nettenxa/NSC/Image/265428386_1372703366477929_293231923148097490_n.jpg

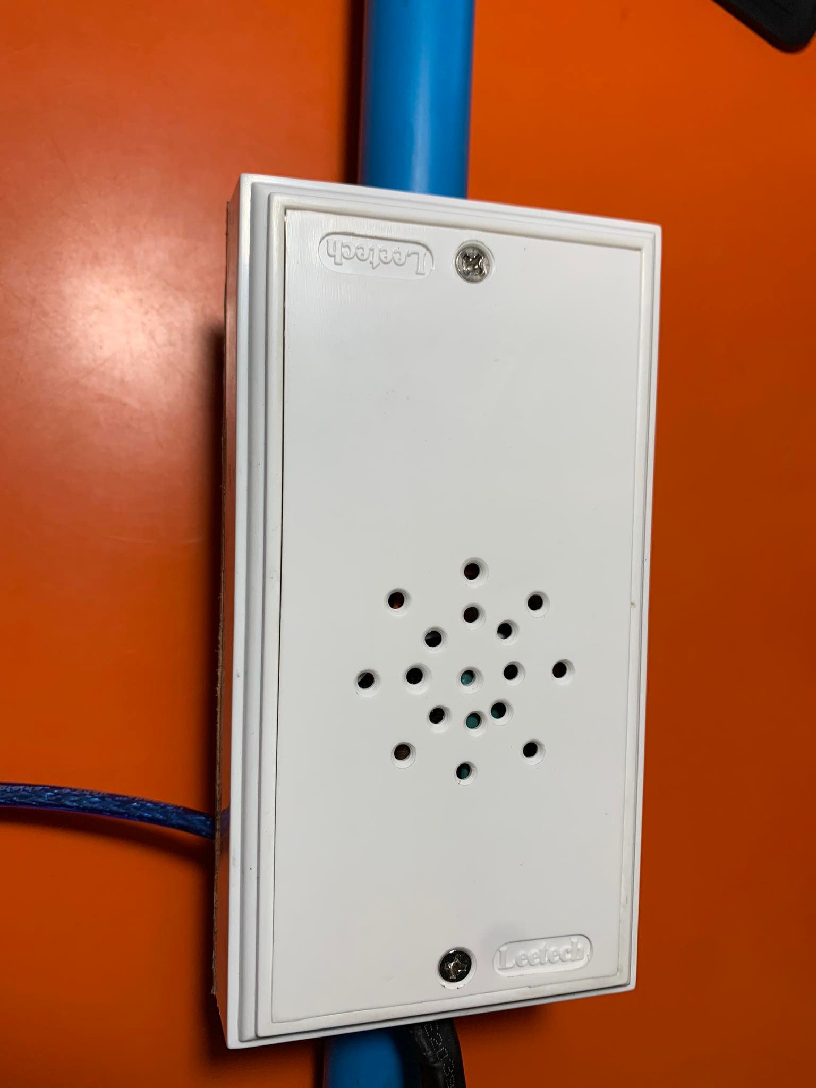
Image/265428386_1372703366477929_293231923148097490_n.jpg
