nettenxa/NSC/Image/กล่อง/sensortail.jpg

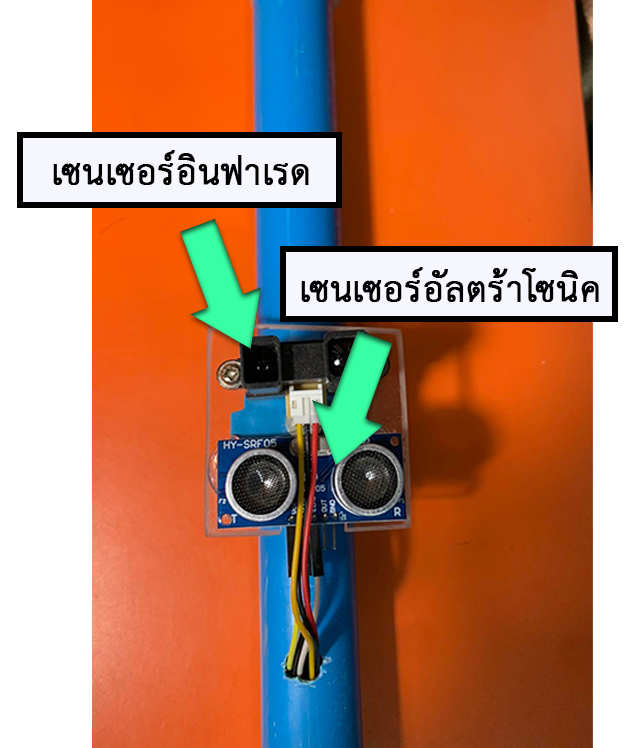
Image/กล่อง/sensortail.jpg
