nettenxa/NSC/Design/2.jpg

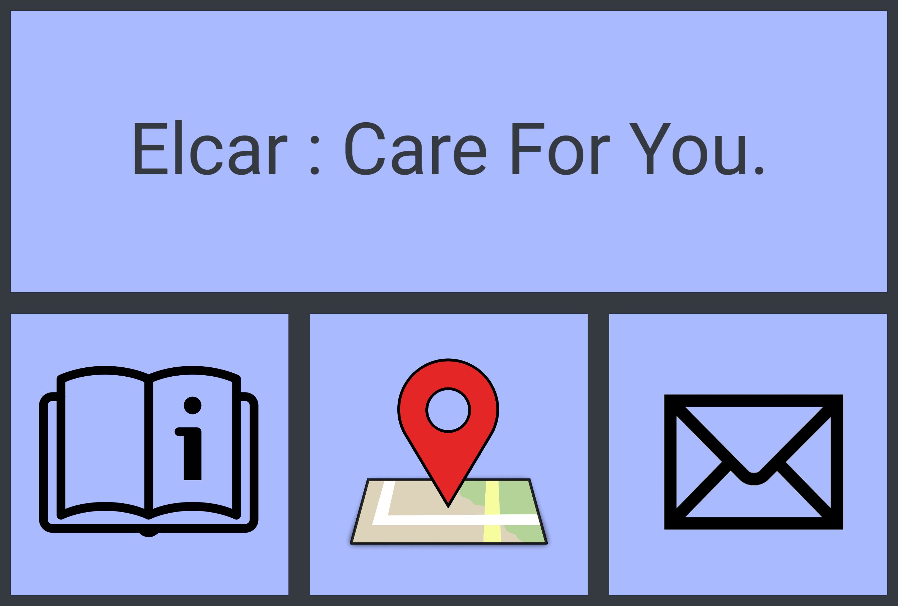
Design/2.jpg
