nettenxa/NSC/Design/Connection.png

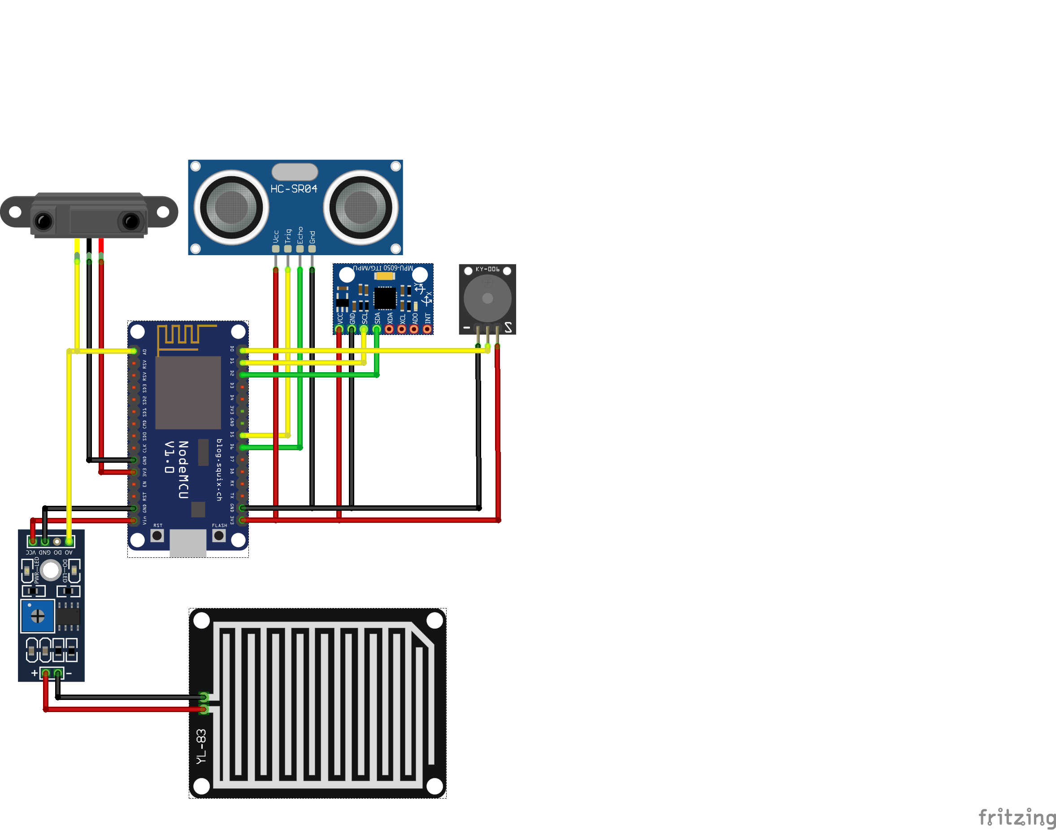
Design/Connection.png
