nettenxa/NSC/Design/Connection_bb-2-Out.png

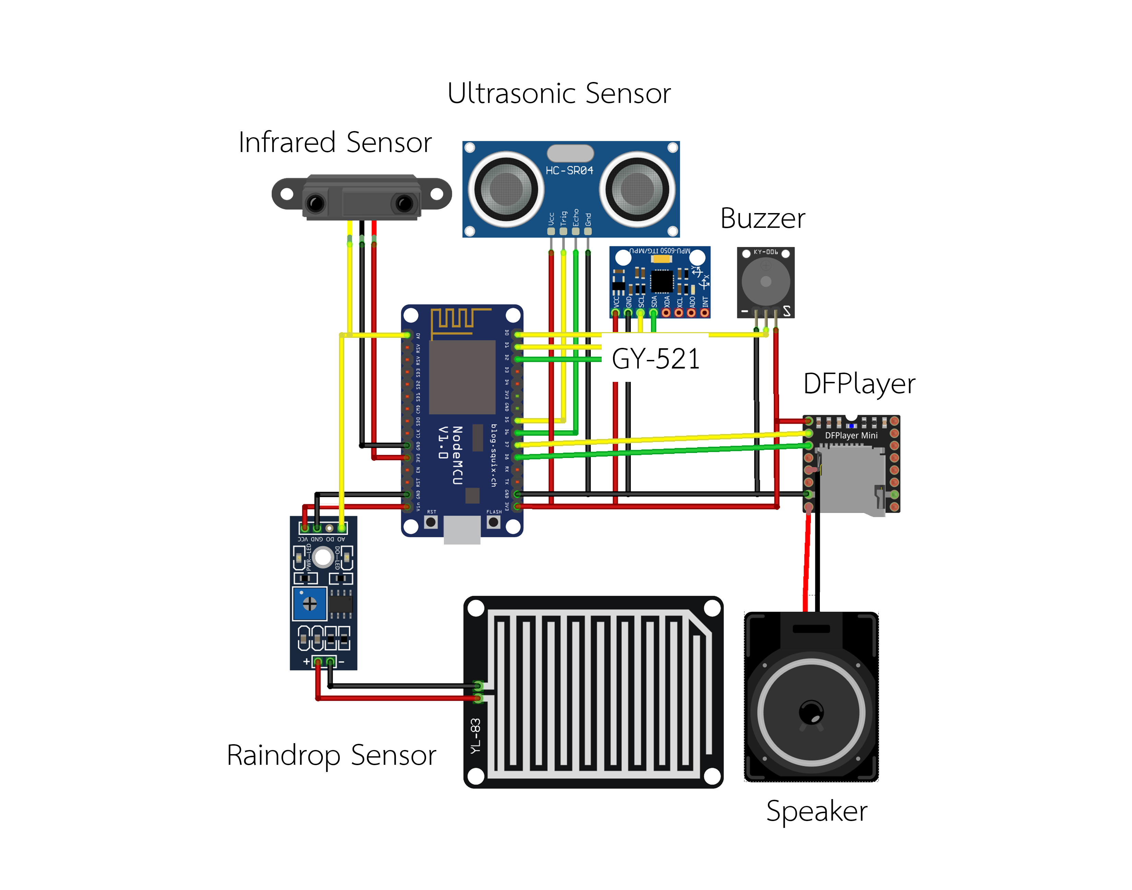
Design/Connection_bb-2-Out.png
