nettenxa/NSC/Design/Connection_bb-2.png

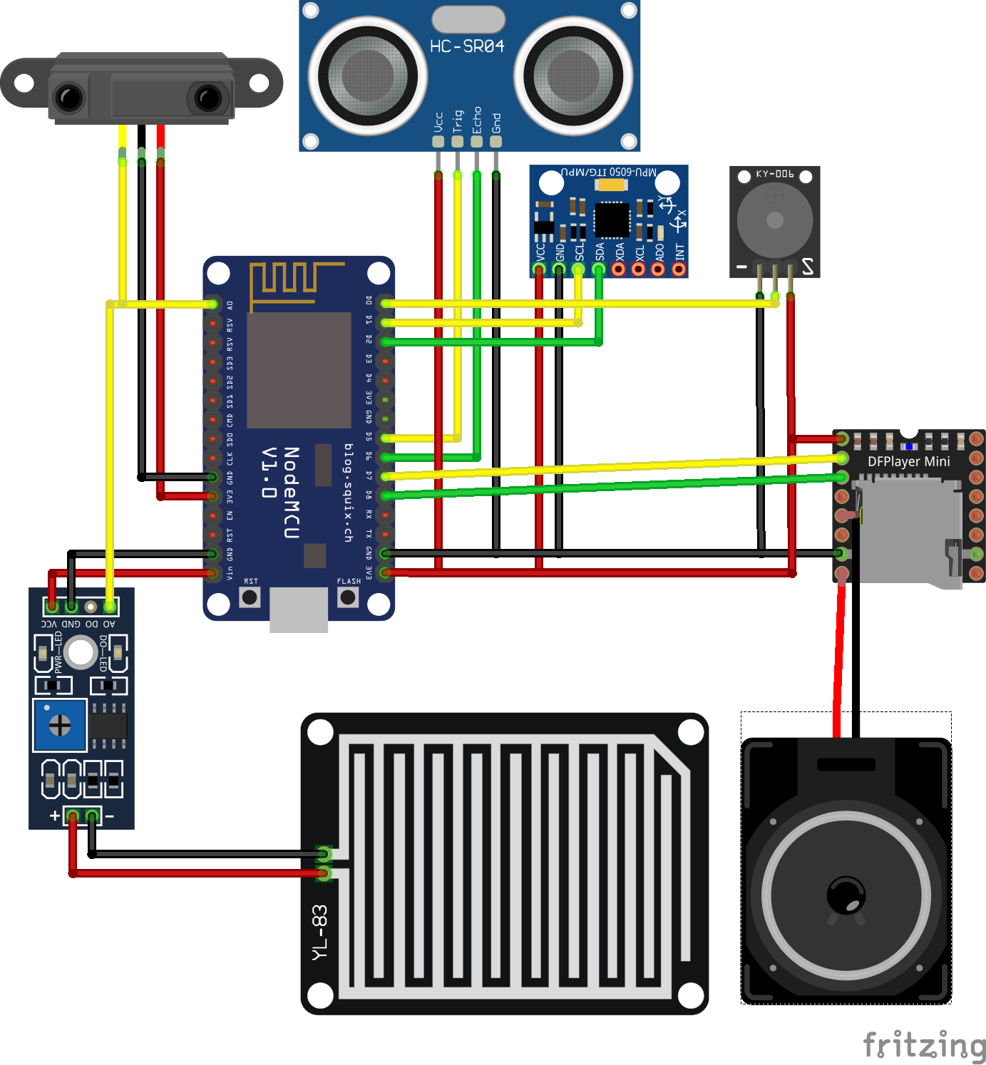
Design/Connection_bb-2.png
