nettenxa/NSC/gg.png

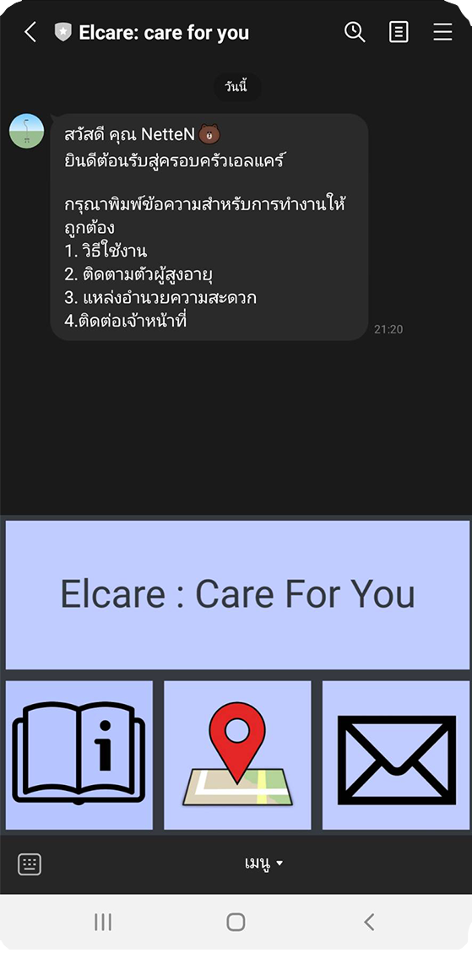
gg.png
