nettenxa/NSC/Image/264776138_958256581741034_5406571611317067341_n.jpg

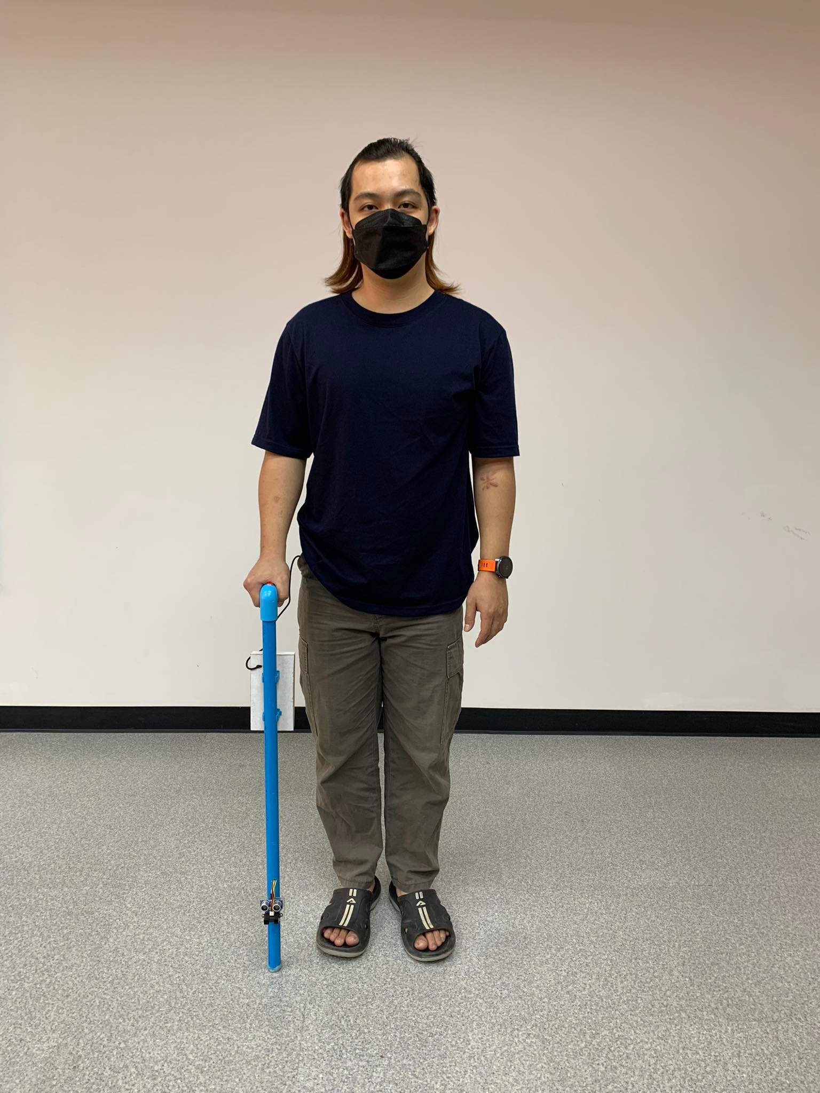
Image/264776138_958256581741034_5406571611317067341_n.jpg
