nettenxa/NSC/Image/264822803_423899012765740_6742990639540808056_n.jpg

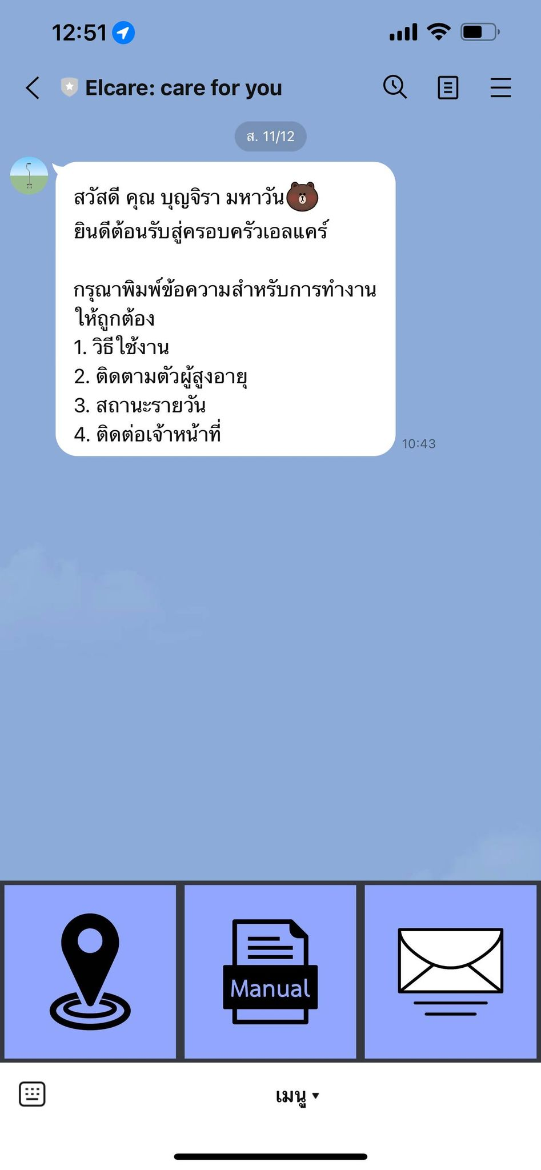
Image/264822803_423899012765740_6742990639540808056_n.jpg
