nettenxa/NSC/Image/265014105_638923154228100_4338517416619523832_n.jpg

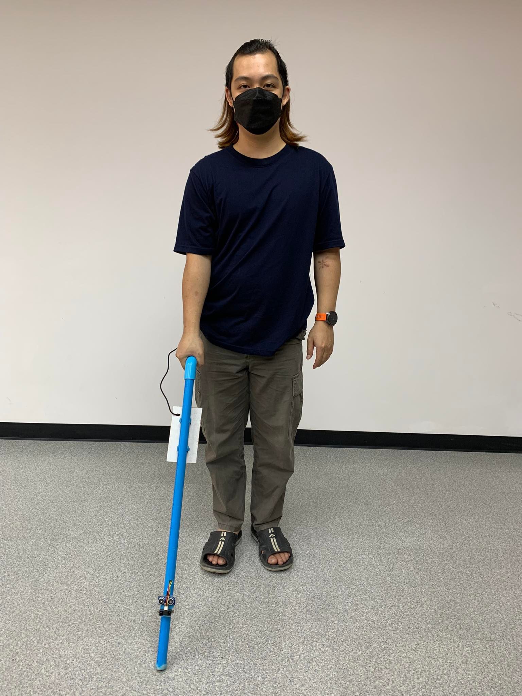
Image/265014105_638923154228100_4338517416619523832_n.jpg
