nettenxa/NSC/Image/265110683_572321093874357_3556969206067001572_n.jpg

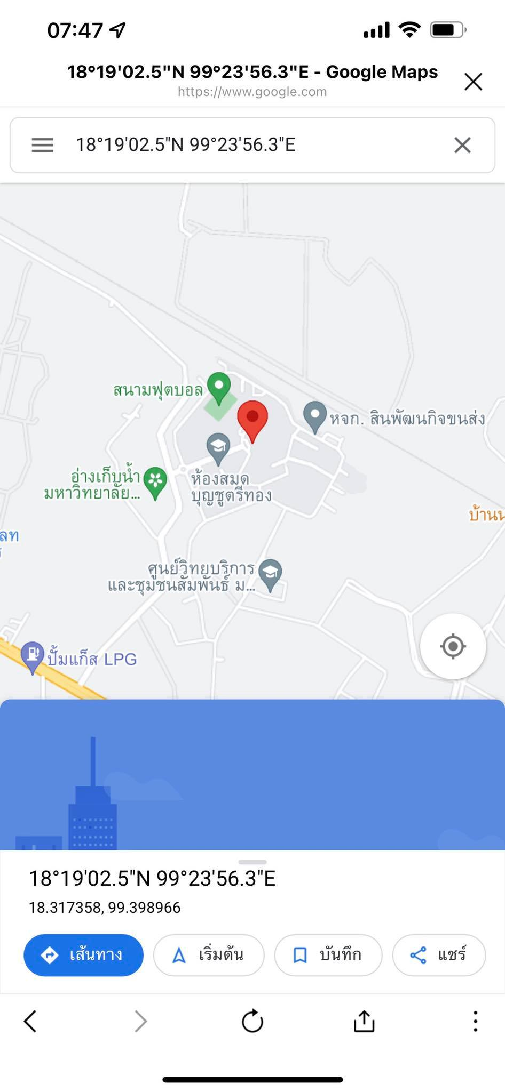
Image/265110683_572321093874357_3556969206067001572_n.jpg
