nettenxa/NSC/Image/265531771_935682650676566_1253015456427634819_n.jpg

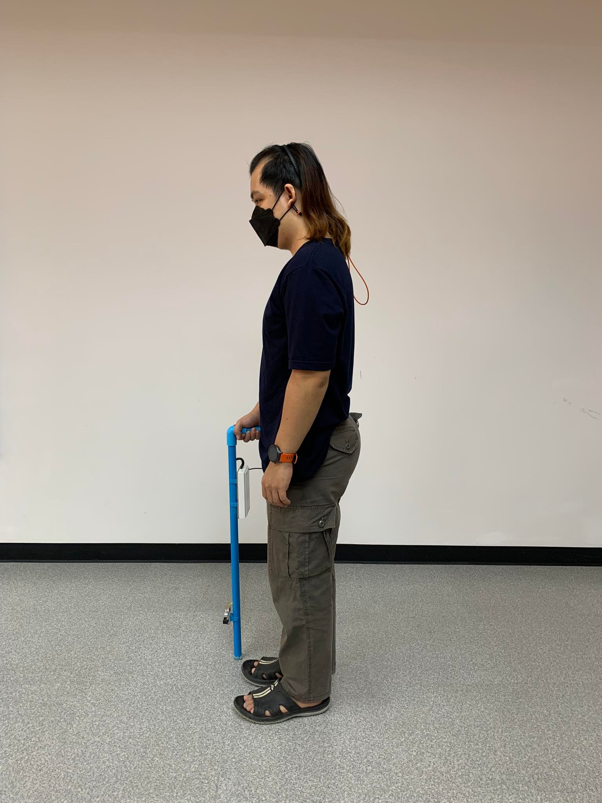
Image/265531771_935682650676566_1253015456427634819_n.jpg
