nettenxa/NSC/Image/266010837_924534368181699_8959451366715135956_n.jpg

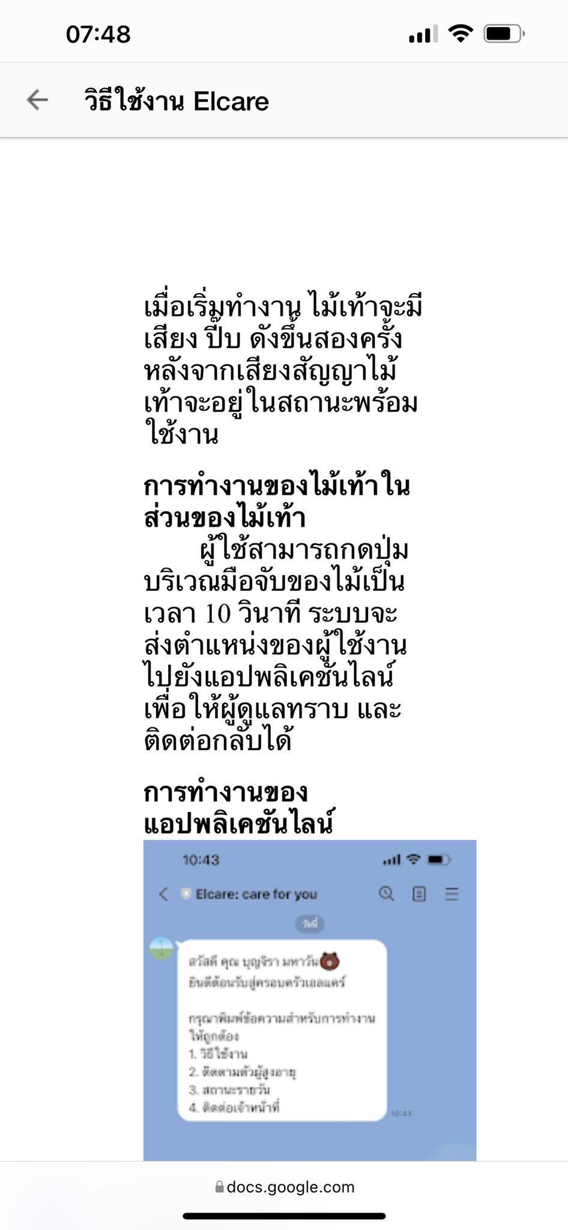
Image/266010837_924534368181699_8959451366715135956_n.jpg
