nettenxa/NSC/Image/266121671_282369093844458_5179473564367191443_n.jpg

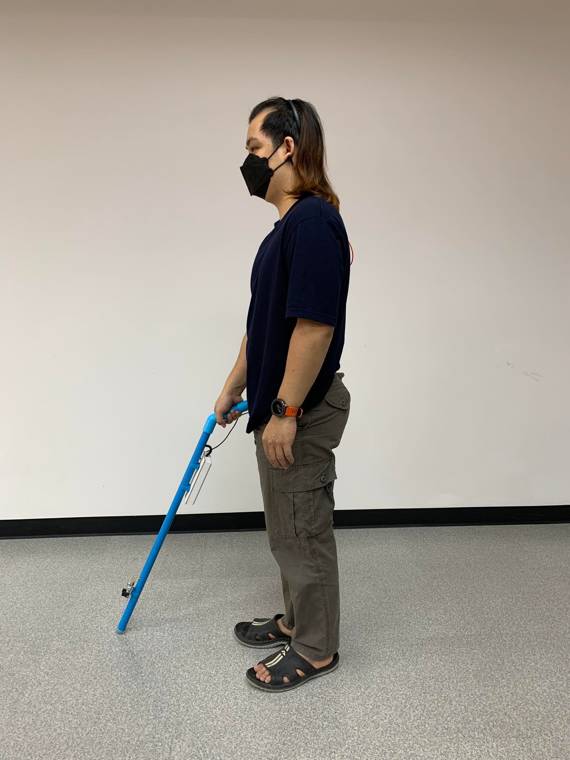
Image/266121671_282369093844458_5179473564367191443_n.jpg
