nettenxa/NSC/Image/266489193_1093051948185362_3606315569262096377_n.jpg

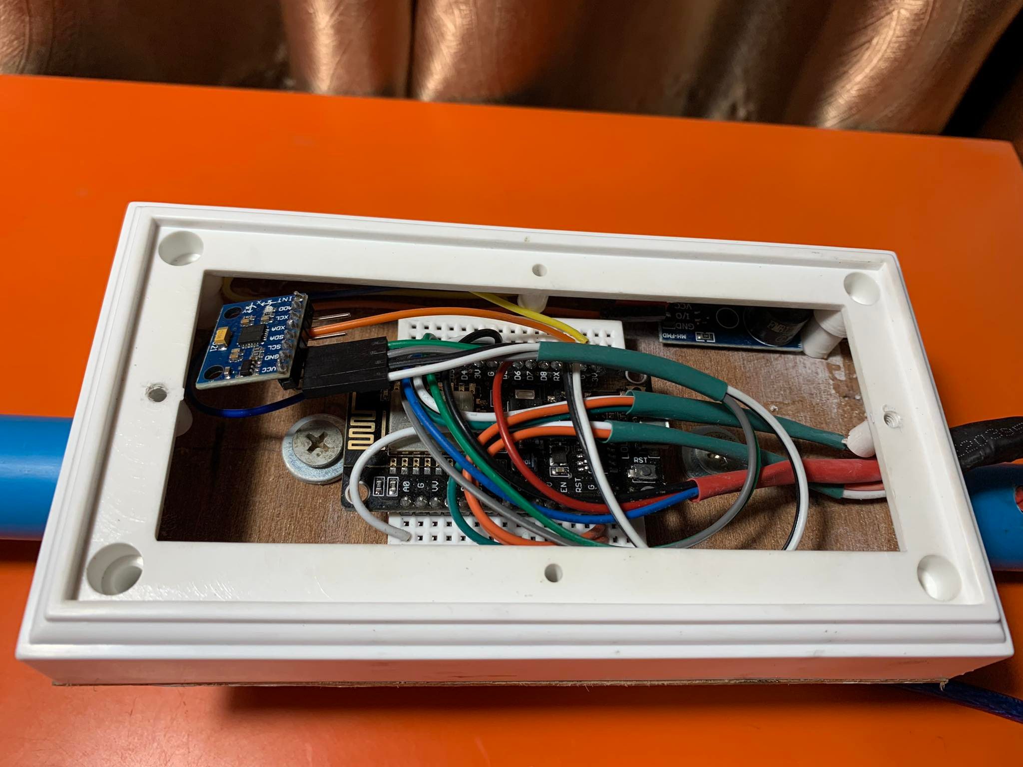
Image/266489193_1093051948185362_3606315569262096377_n.jpg
