nettenxa/NSC/Image/266701049_331945328578467_1472730055581550721_n.jpg

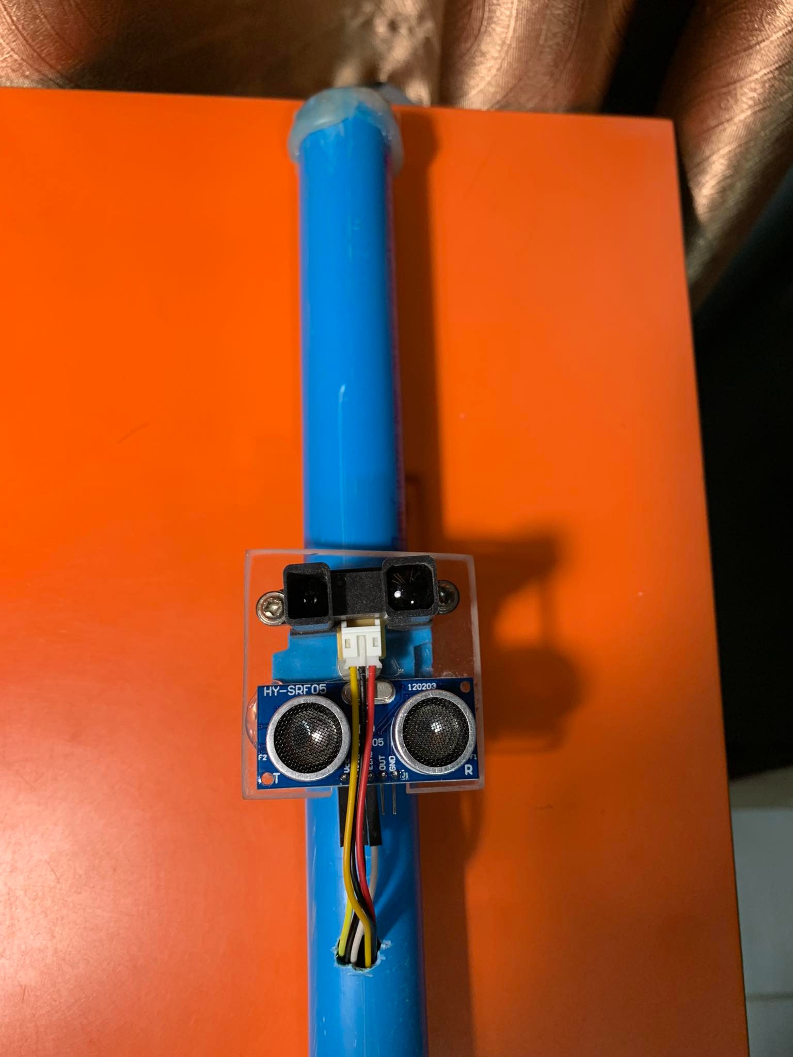
Image/266701049_331945328578467_1472730055581550721_n.jpg
