nettenxa/NSC/Image/266968699_627225355388466_1541936651428918515_n.jpg

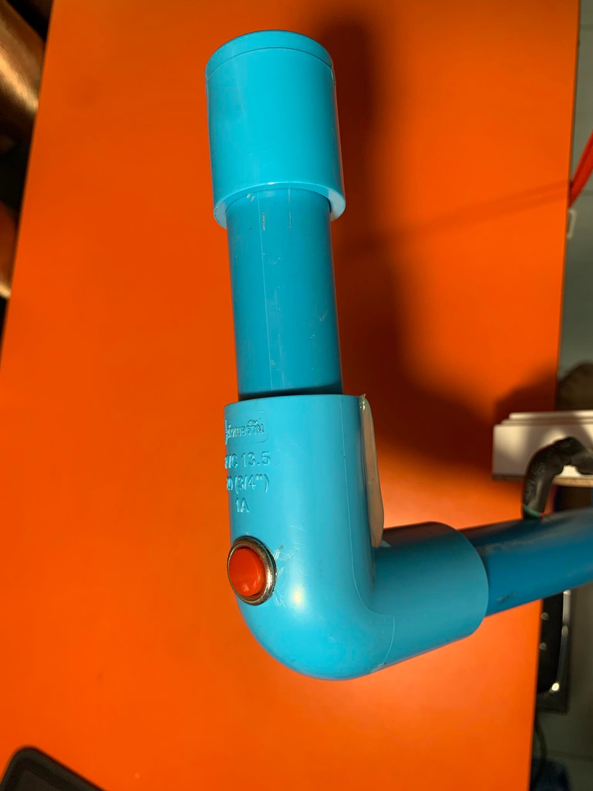
Image/266968699_627225355388466_1541936651428918515_n.jpg
