nettenxa/NSC/Image/267014538_4587867214637260_2955878110535487857_n.jpg

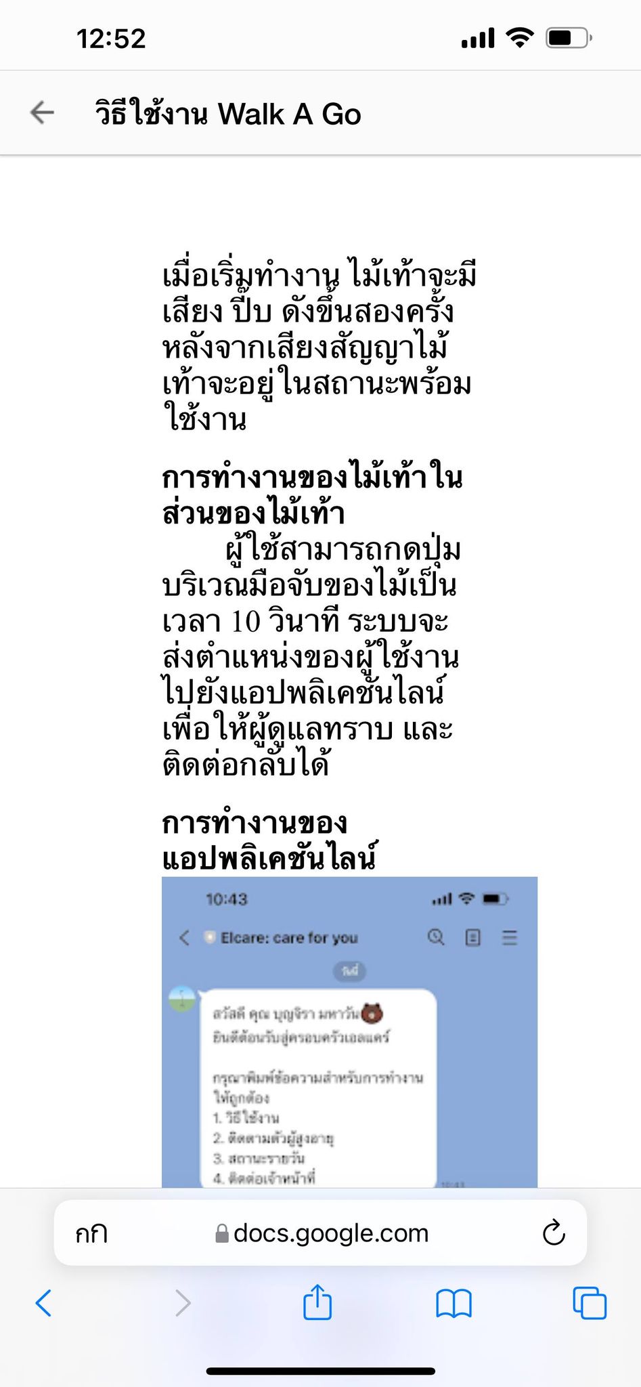
Image/267014538_4587867214637260_2955878110535487857_n.jpg
