nettenxa/NSC/Image/267402559_982161962650128_3099172975754466114_n.jpg

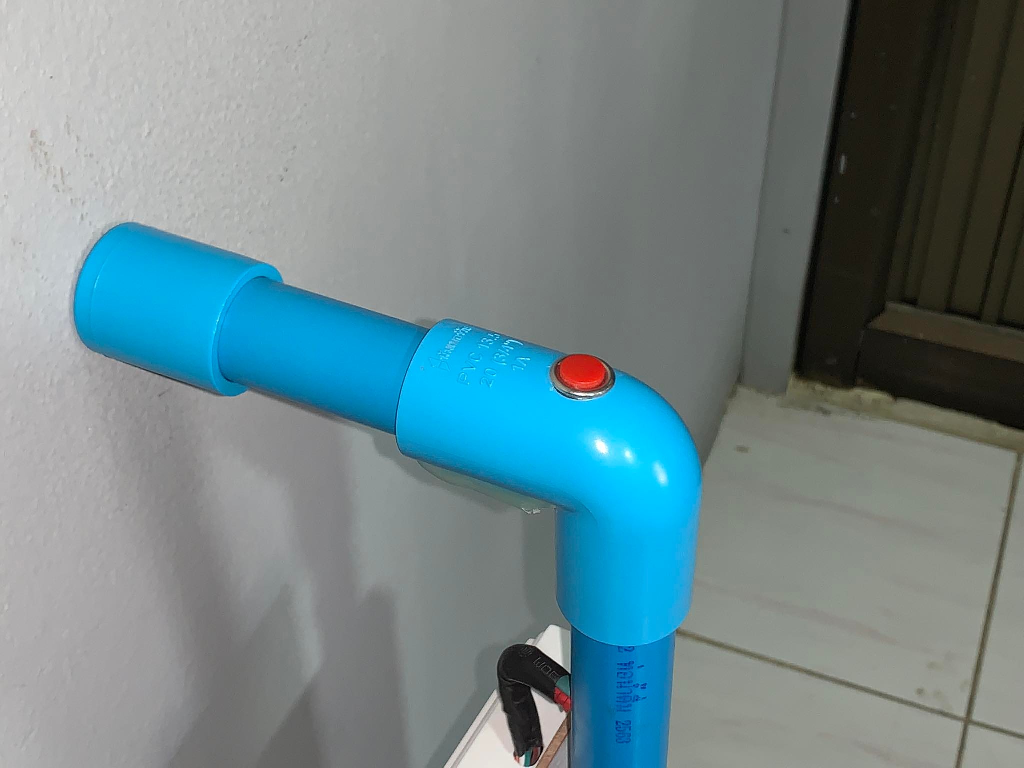
Image/267402559_982161962650128_3099172975754466114_n.jpg
