nettenxa/NSC/Image/267537610_1544595275903317_5843541208619142849_n.jpg

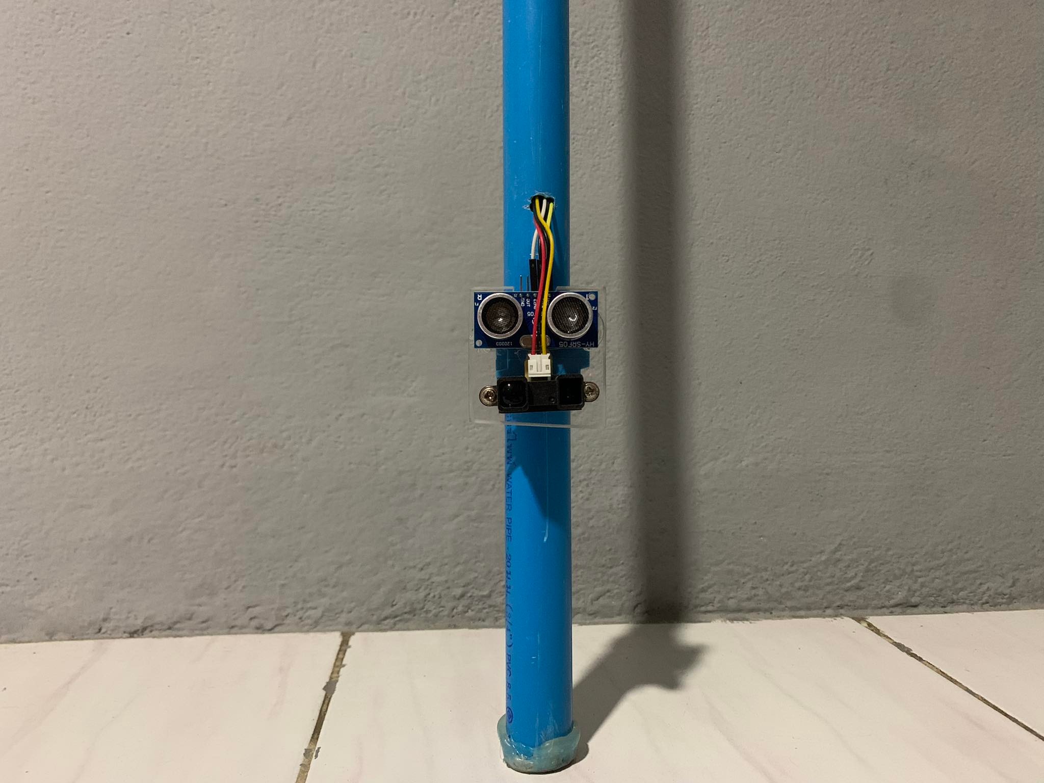
Image/267537610_1544595275903317_5843541208619142849_n.jpg
