nettenxa/NSC/Image/AUCC2022.drawio.png

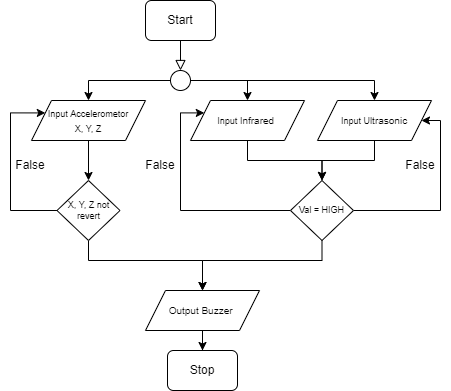
Image/AUCC2022.drawio.png
