nettenxa/NSC/Image/Hand.png

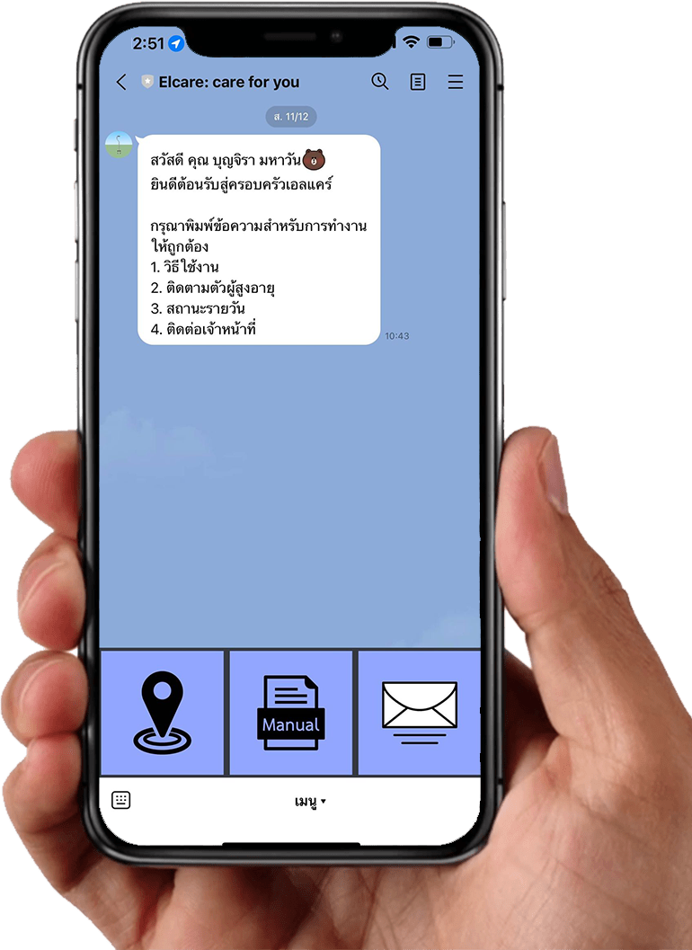
Image/Hand.png
