nettenxa/NSC/Image/Out copy.png

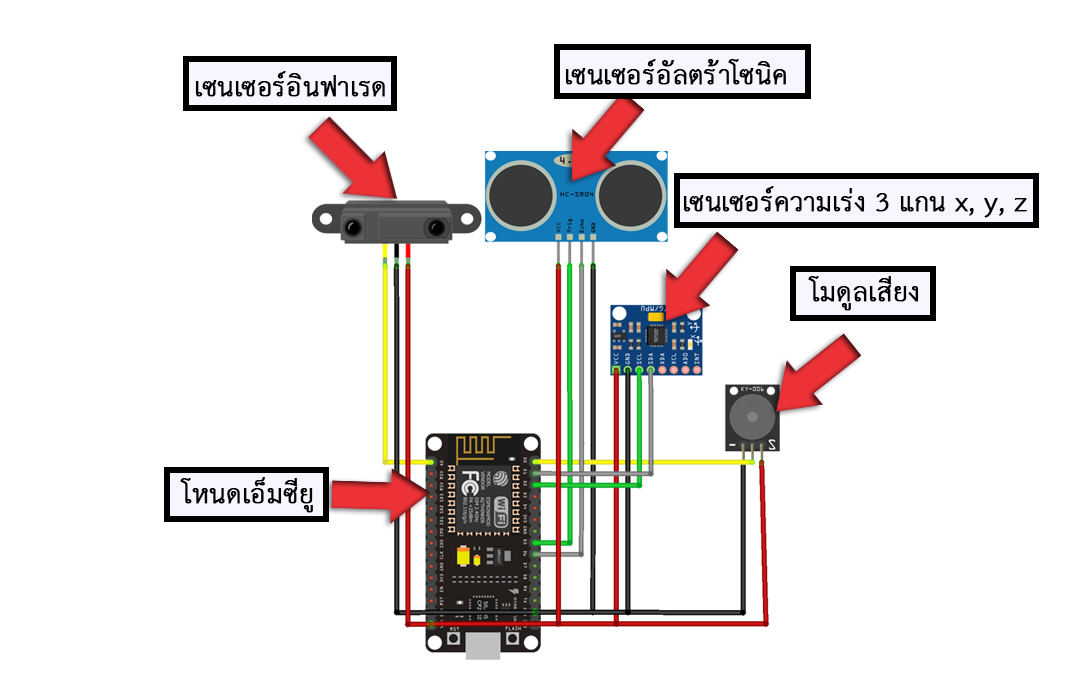
Image/Out copy.png
