nettenxa/NSC/Image/OutPro.png

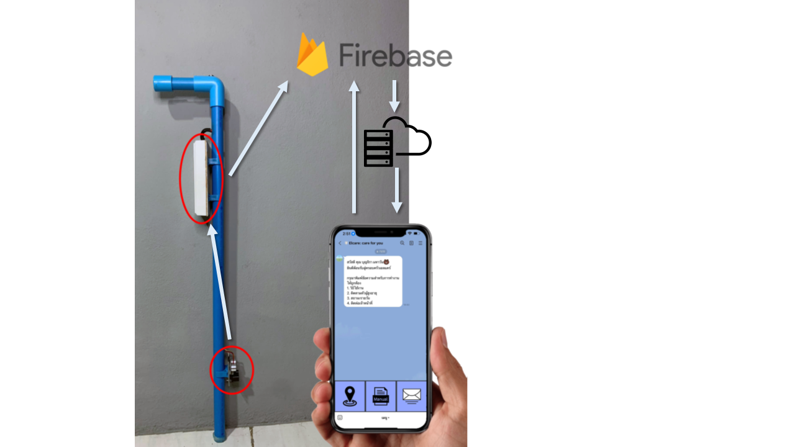
Image/OutPro.png
