nettenxa/NSC/Image/กล่อง/sensor.jpg

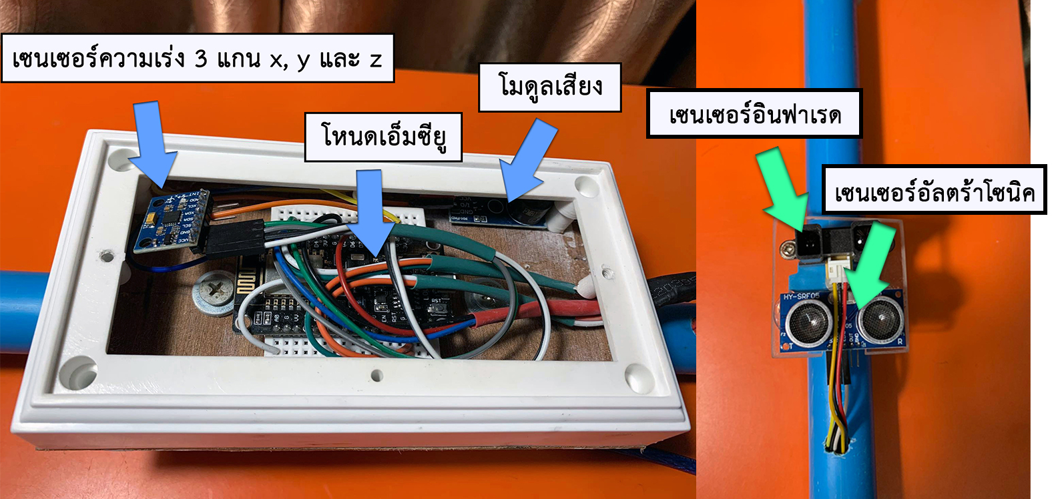
Image/กล่อง/sensor.jpg
