nettenxa/NSC/Image/กล่อง/ปิดฝา.jpg

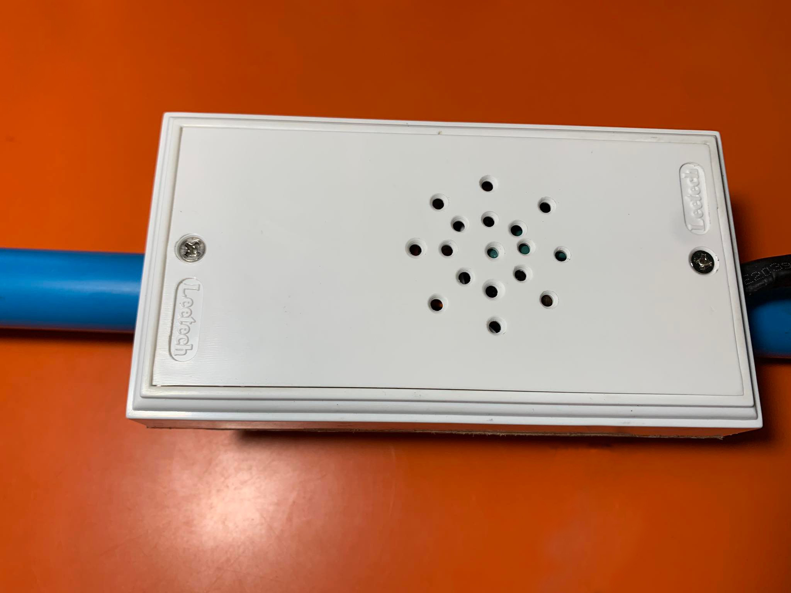
Image/กล่อง/ปิดฝา.jpg
