nettenxa/NSC/Image/กล่อง/เปิดฝาBB.jpg

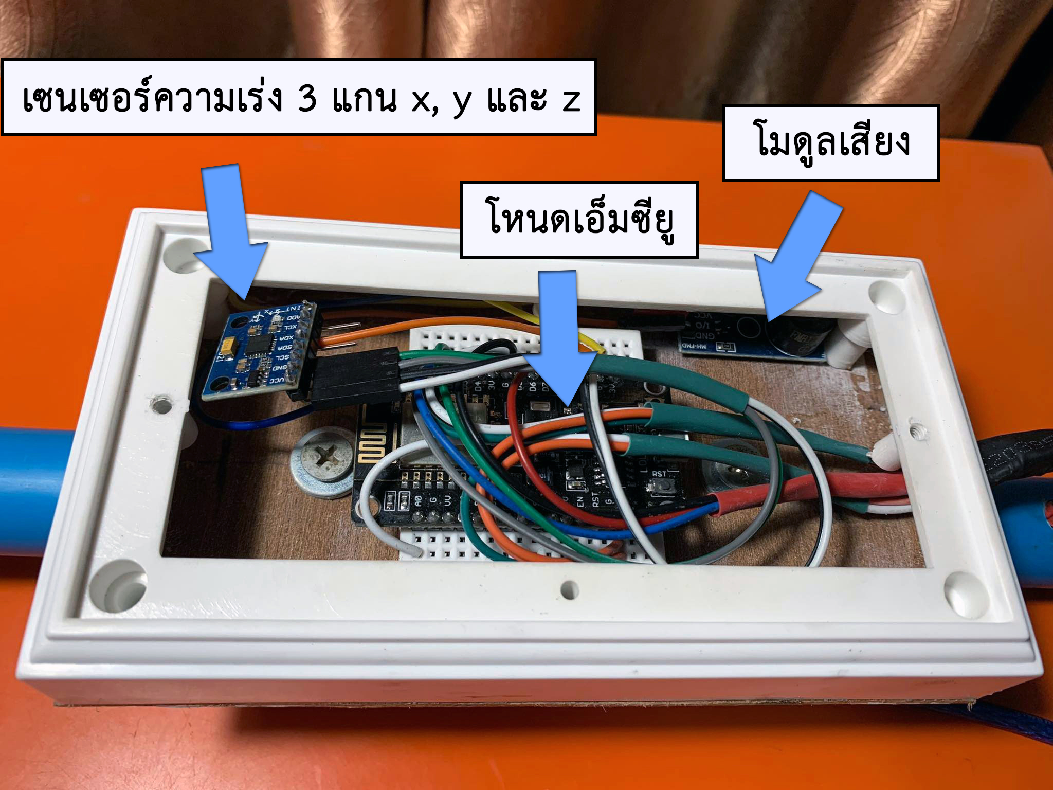
Image/กล่อง/เปิดฝาBB.jpg
