nettenxa/NSC/Image/ภาพรวม.jpg

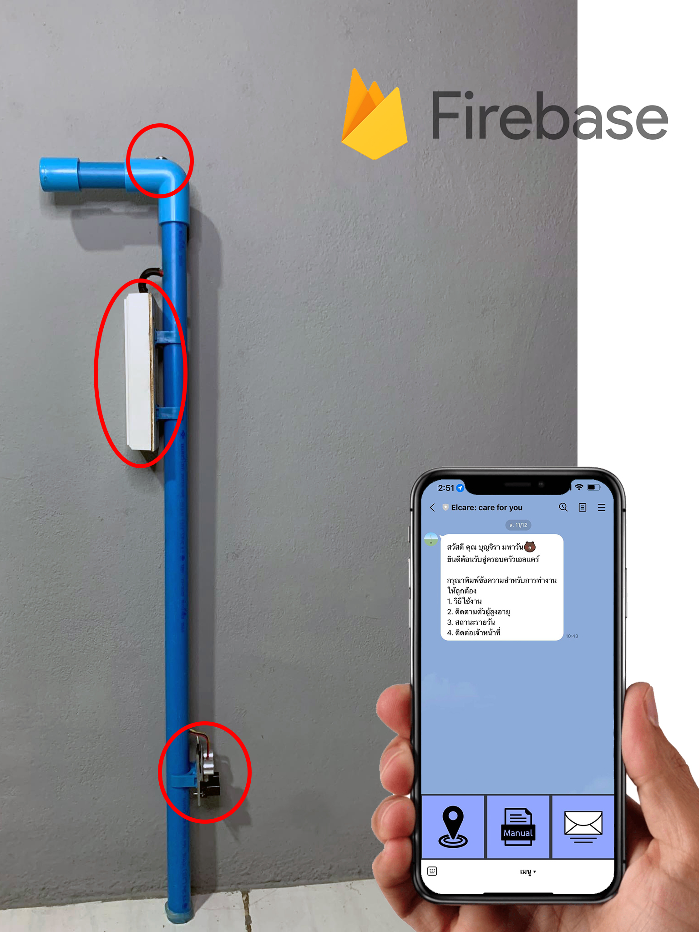
Image/ภาพรวม.jpg
