nettenxa/NSC/Image/รูปภาพ1.jpg

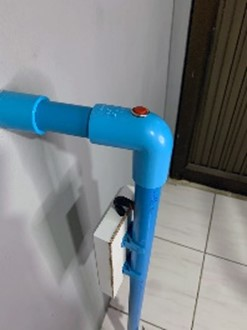
Image/รูปภาพ1.jpg
