nettenxa/NSC/Line Image/415.jpg

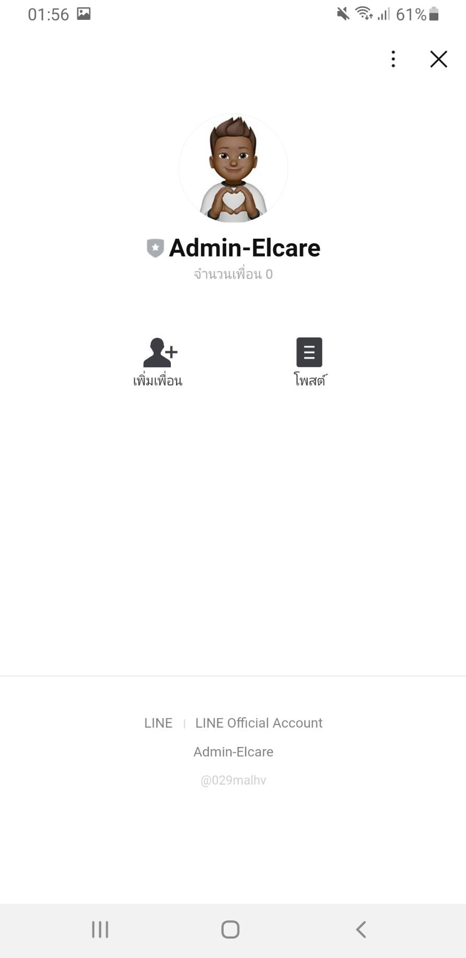
Line Image/415.jpg
