nettenxa/NSC/Line Image/416.jpg

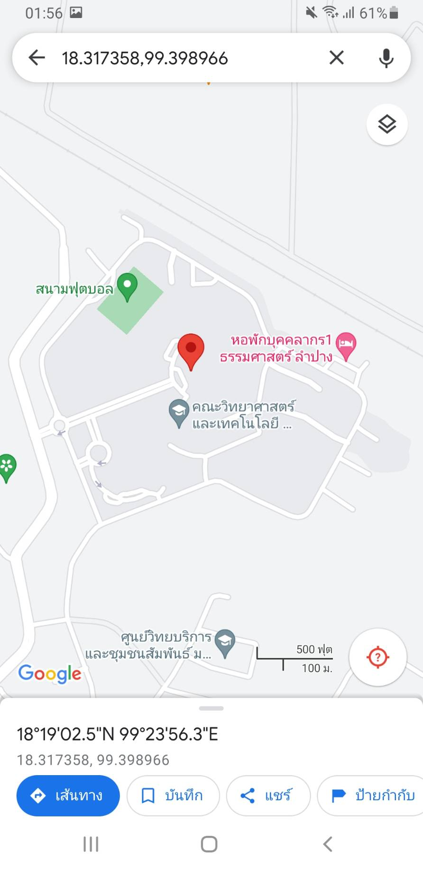
Line Image/416.jpg
