nettenxa/NSC/Line Image/Home 2.jpg

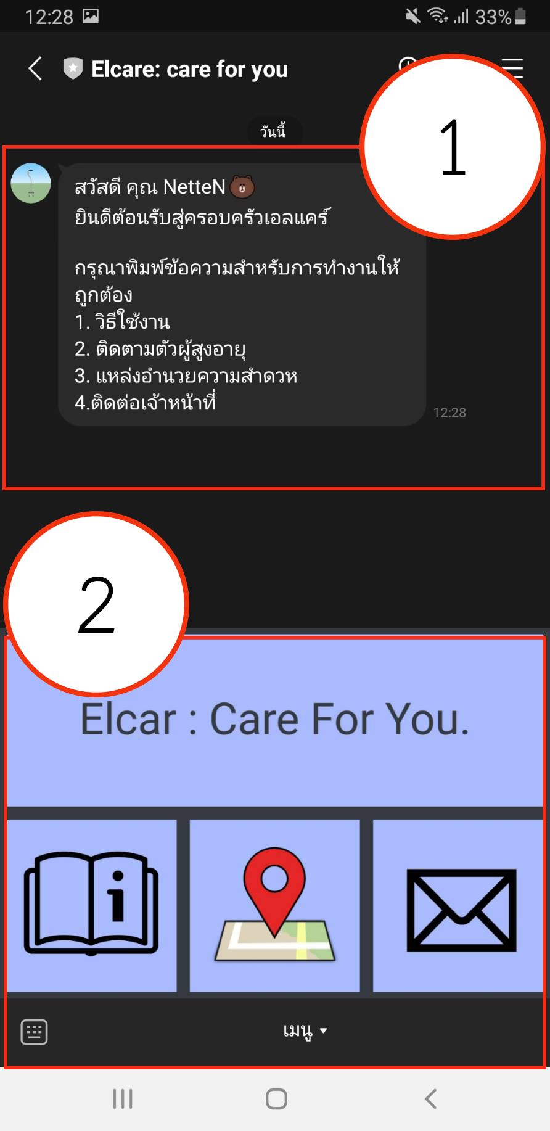
Line Image/Home 2.jpg
