nettenxa/NSC/Line Image/ผู้ใช้งาน/445.jpg

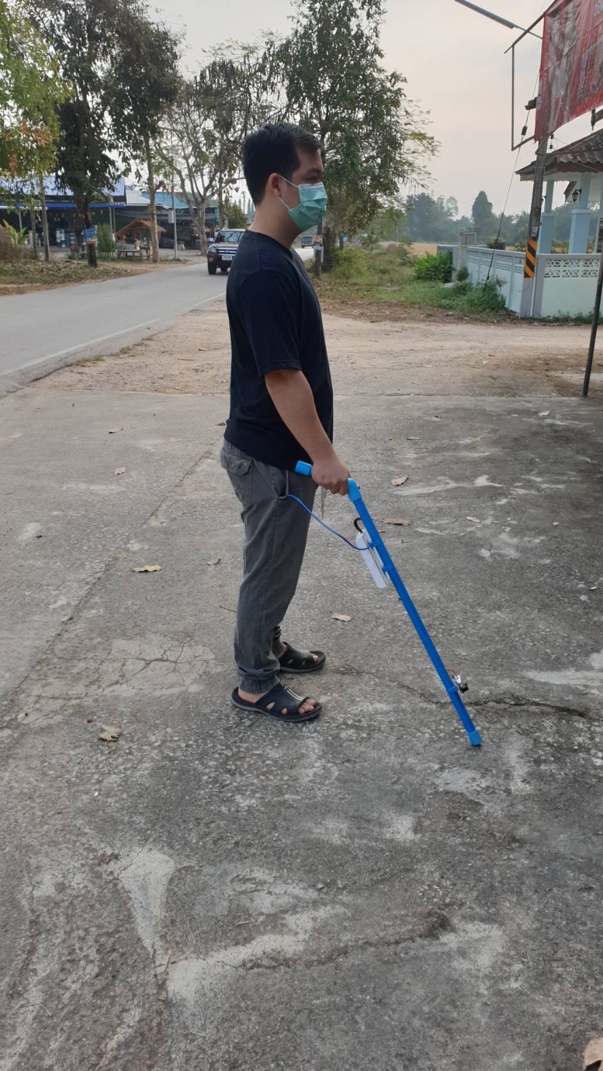
Line Image/ผู้ใช้งาน/445.jpg
