nettenxa/NSC/Line Image/ผู้ใช้งาน/446.jpg

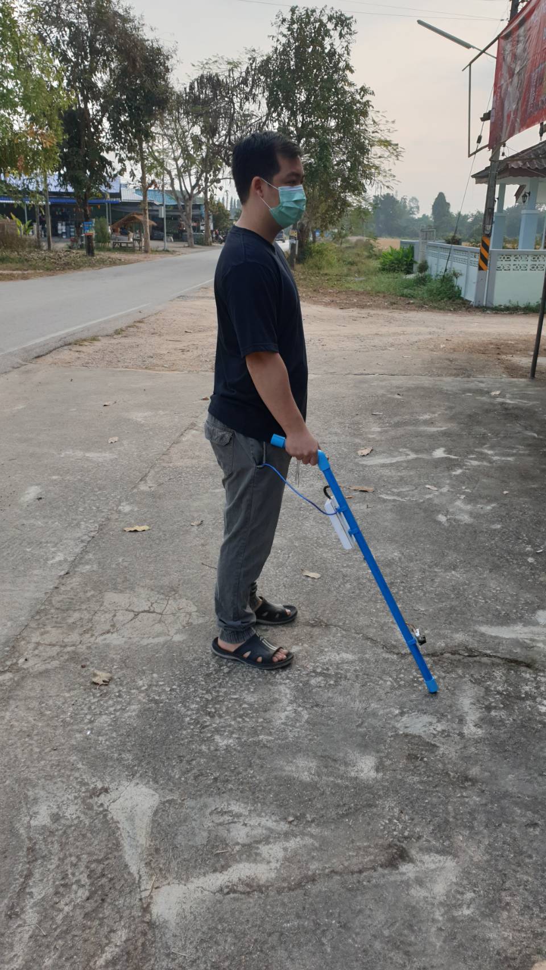
Line Image/ผู้ใช้งาน/446.jpg
