nettenxa/NSC/Line Image/ผู้ใช้งาน/448.jpg

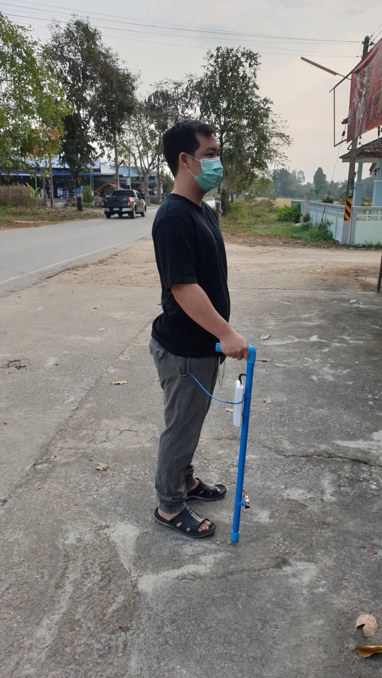
Line Image/ผู้ใช้งาน/448.jpg
