nettenxa/NSC/Line Image/ผู้ใช้งาน/449.jpg

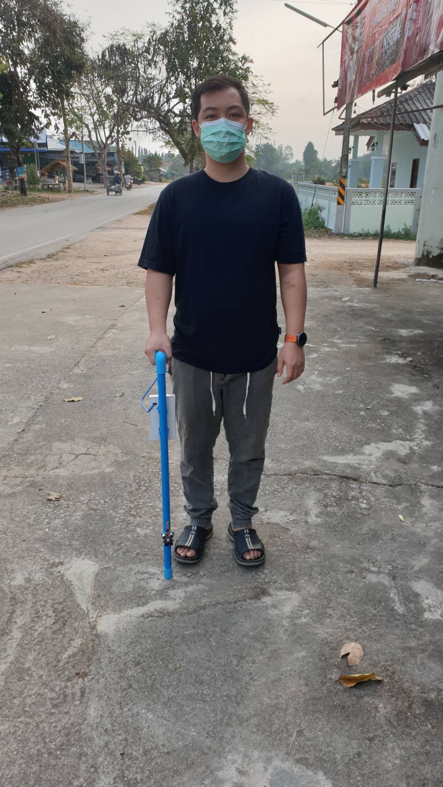
Line Image/ผู้ใช้งาน/449.jpg
