nettenxa/NSC/Line Image/อุปกรณ์/1.jpg

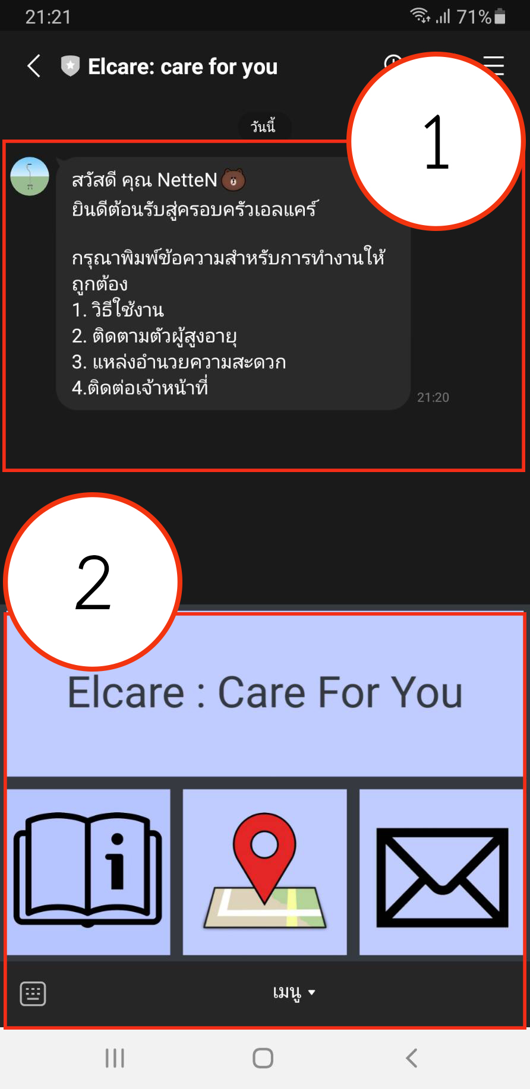
Line Image/อุปกรณ์/1.jpg
