nettenxa/NSC/Line Image/อุปกรณ์/2.jpg

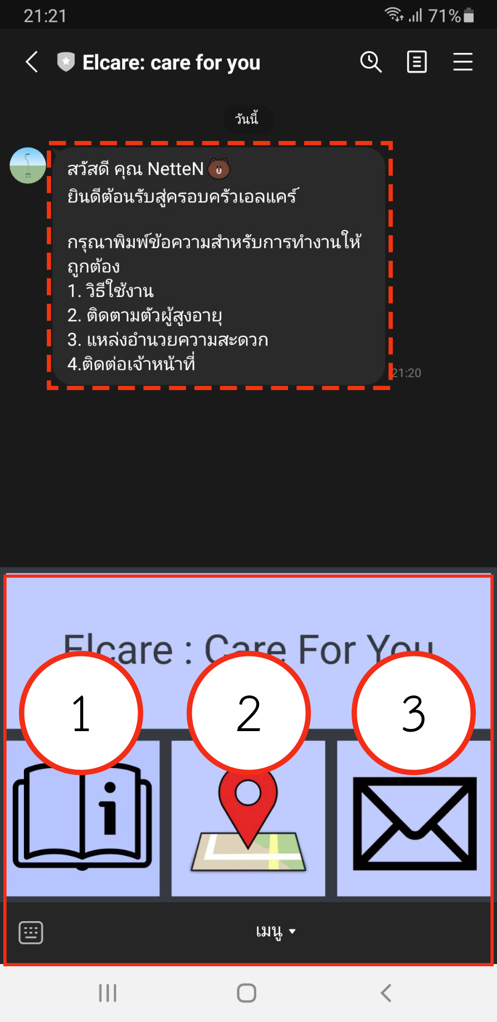
Line Image/อุปกรณ์/2.jpg
