nettenxa/NSC/Line Image/อุปกรณ์/437.jpg

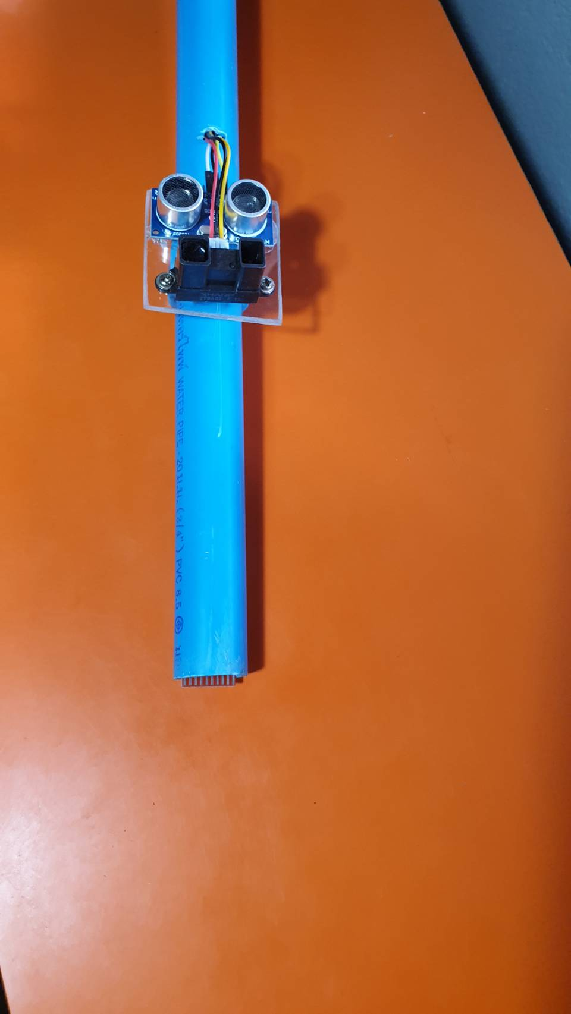
Line Image/อุปกรณ์/437.jpg
