nettenxa/NSC/Line Image/อุปกรณ์/438.jpg

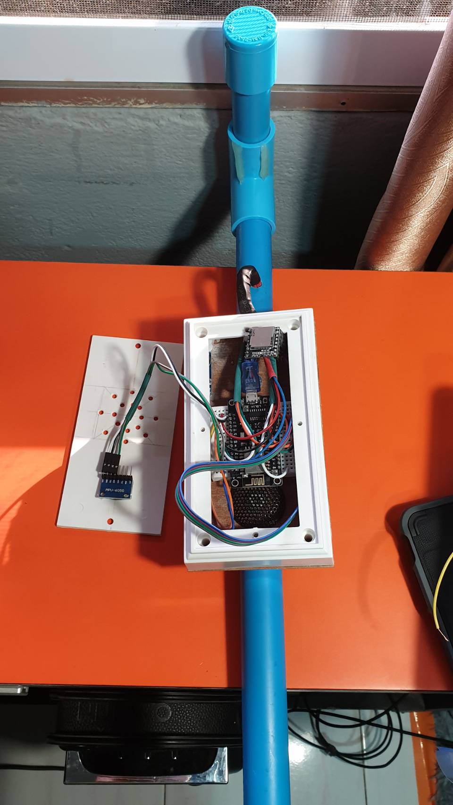
Line Image/อุปกรณ์/438.jpg
