nettenxa/NSC/Line Image/อุปกรณ์/439.jpg

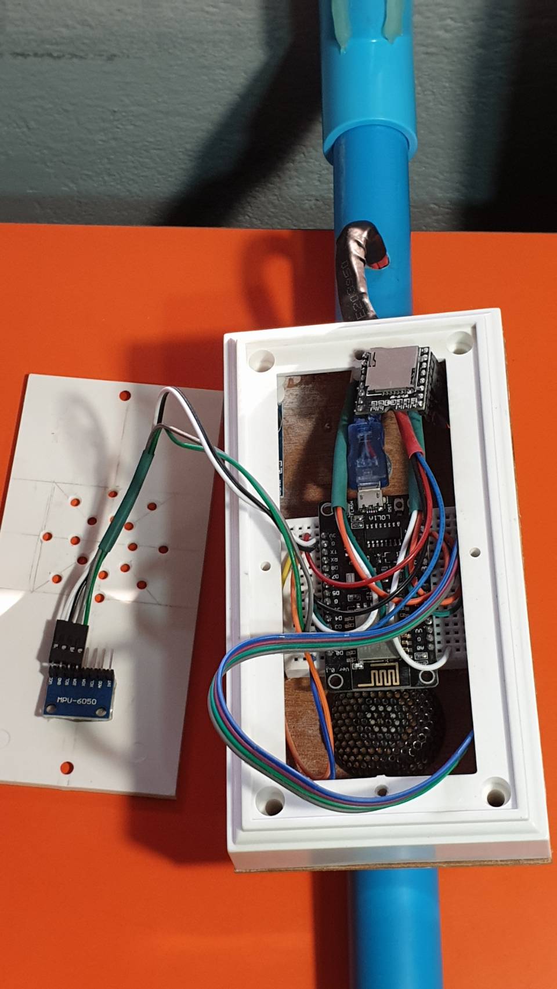
Line Image/อุปกรณ์/439.jpg
