nettenxa/NSC/Line Image/อุปกรณ์/455.jpg

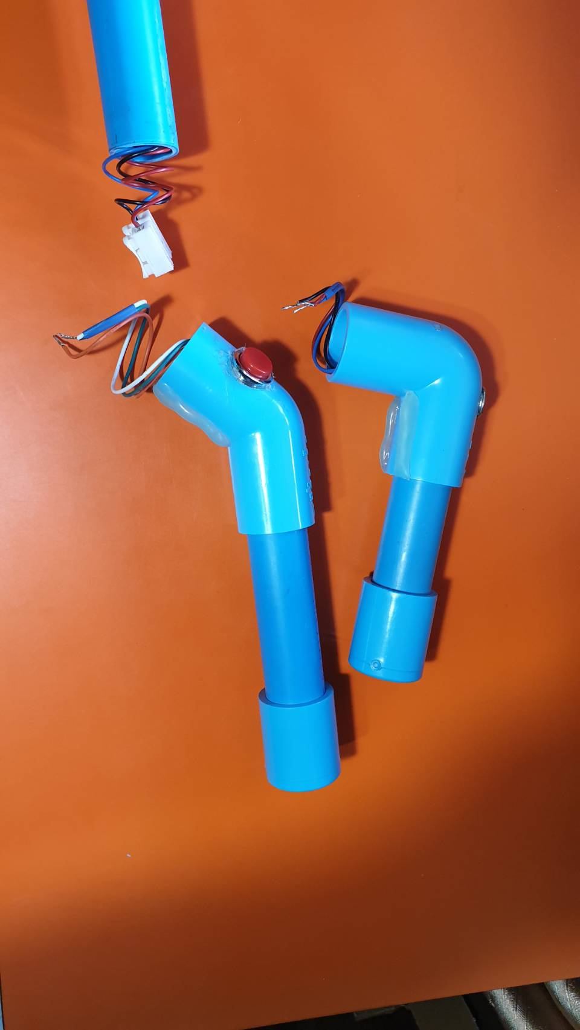
Line Image/อุปกรณ์/455.jpg
