nettenxa/NSC/Line Image/ไม้เท้า/431.jpg

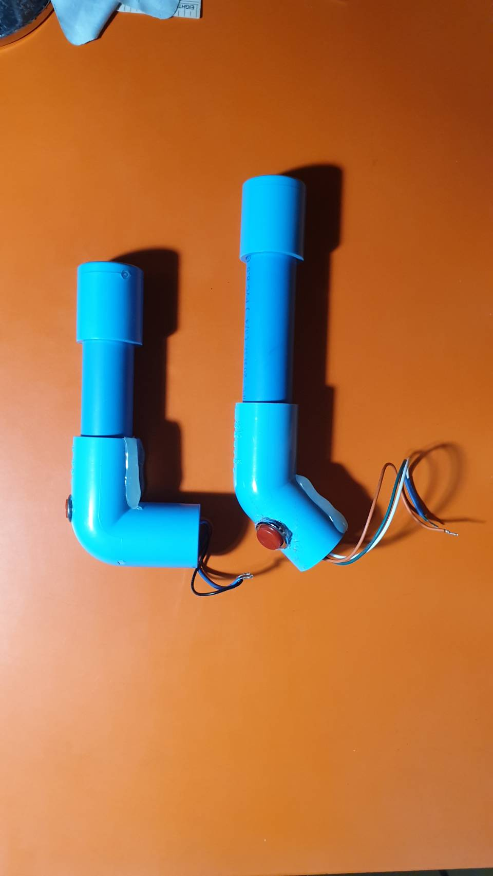
Line Image/ไม้เท้า/431.jpg
