nettenxa/NSC/Line Image/ไม้เท้า/432.jpg

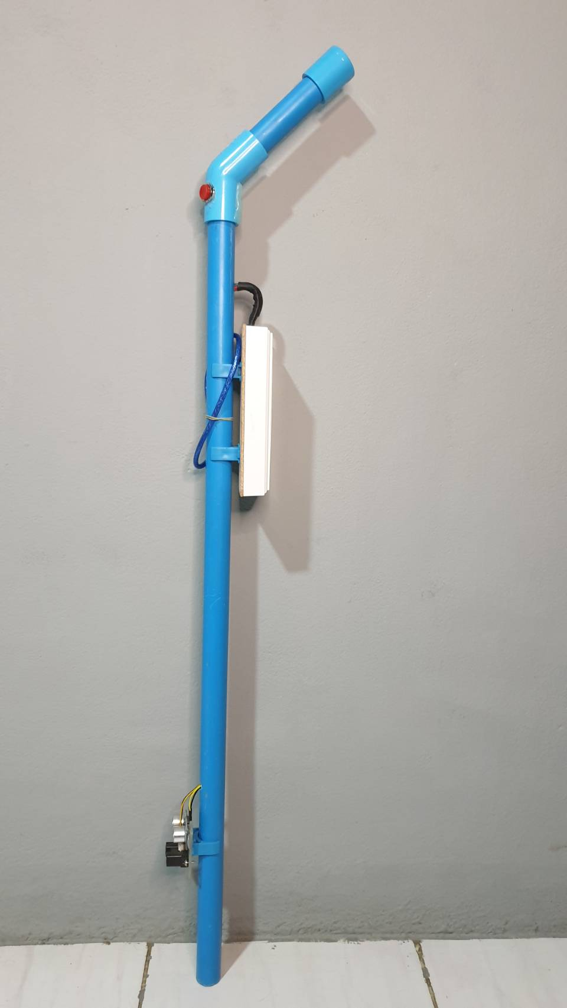
Line Image/ไม้เท้า/432.jpg
