nettenxa/NSC/Line Image/ไม้เท้า/434.jpg

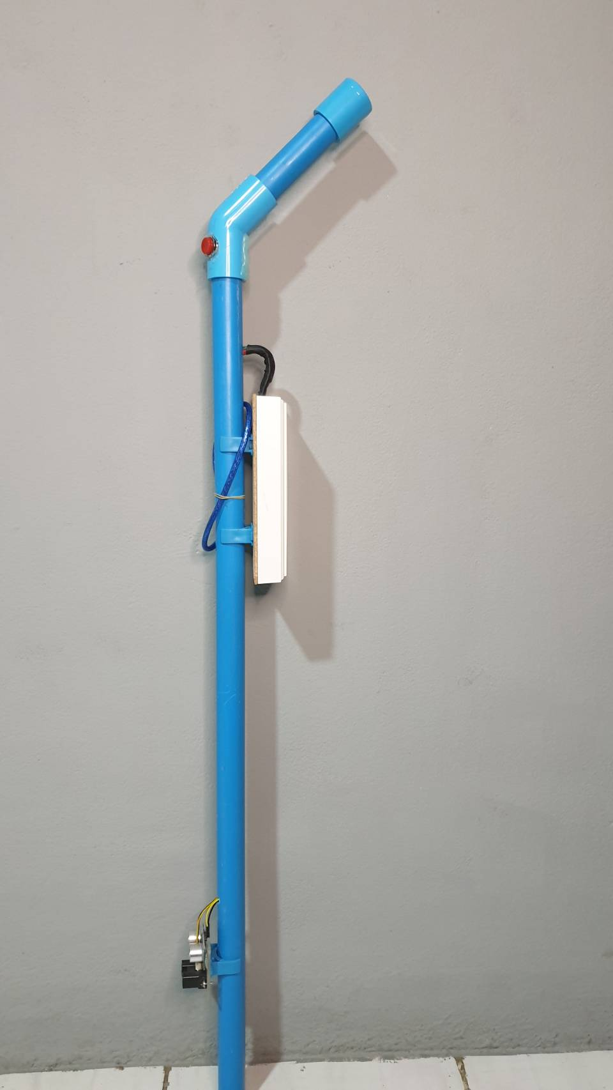
Line Image/ไม้เท้า/434.jpg
