nettenxa/NSC/samsung.png

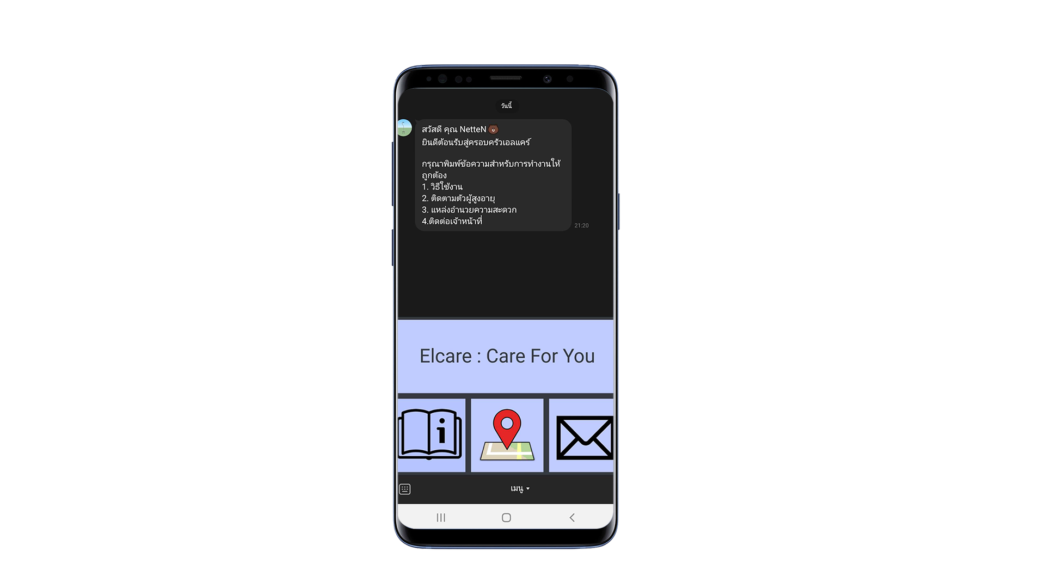
samsung.png
