nettenxa/NSC/มือถือ.png

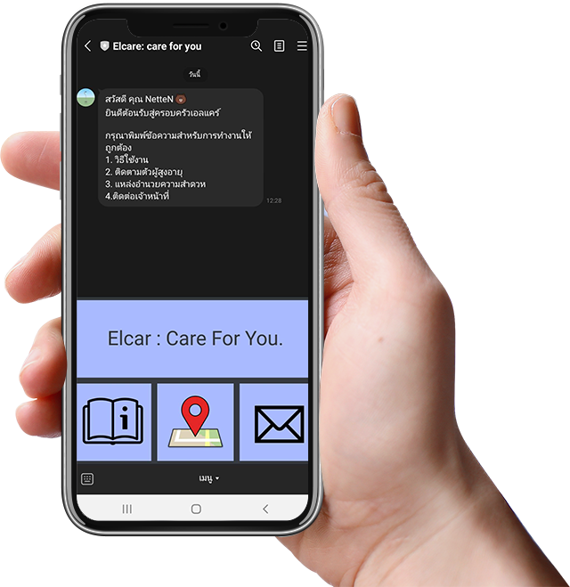
มือถือ.png
