nettenxa/NSC/ไม้เท้า copy.png

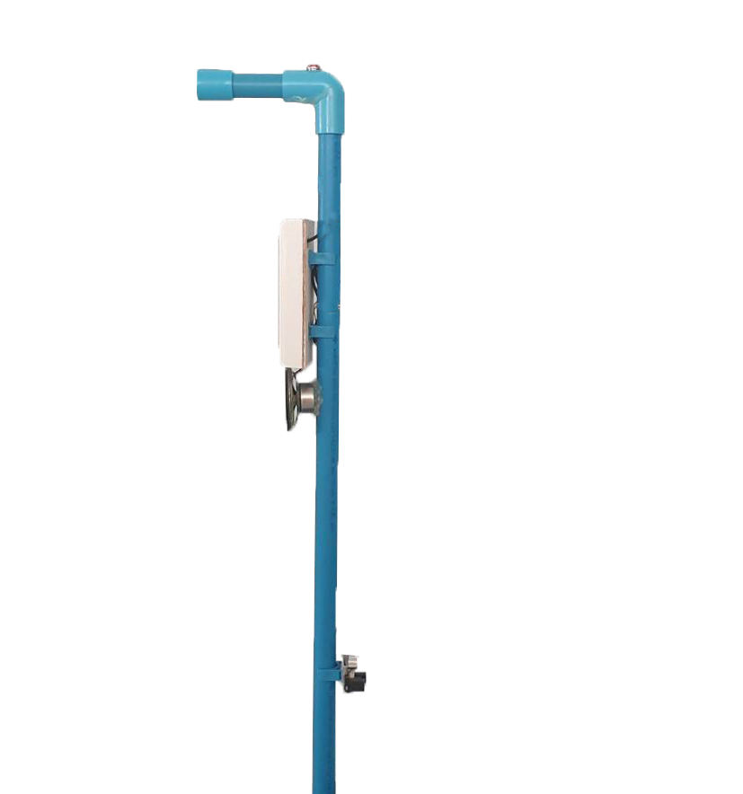
ไม้เท้า copy.png
