nettenxa/NSC/(list of files, drawings)

Other design files:
Design/Connection.fzz
